jivespark/Breadboard-computer/Breadboard computer/Breadboard computer.kicad_pcb

## KiCad design tactile_capacitive/tactile_capacitive.kicad_sch


Parts:
C_sensor, C_sensor1, C_sensor2, C_sensor3: 3.5pF
C_wires, C_wires1, C_wires2, C_wires3: 20pF
J3: EnableA; PinHeader_1x02_P1.27mm_Vertical
J4: EnableB; PinHeader_1x02_P1.27mm_Vertical
J5: Conn_01x04_Pin; PinHeader_1x04_P1.27mm_Vertical
U1: ESP32-WROOM-32
U2: HX711; SOIC-16_3.9x9.9mm_P1.27mm
U4: L298N; TO127P2020X500X2100-15

Connections:
+5V: J3.2, J4.2, U1.2 (VDD), U4.4 (VS), U4.9 (VSS)
C1: U1.27 (IO16)
C2: U1.28 (IO17)
DT: U1.30 (IO18)
ESP_TO_LAPTOP: U1.35 (TXD0/IO1)
GND: C_sensor.2, C_sensor1.2, C_sensor2.2, C_sensor3.2, C_wires.2, C_wires1.2, C_wires2.2, C_wires3.2, U1.1 (GND), U1.15 (GND), U1.38 (GND), U1.39 (GND), U4.1 (SENSE_A), U4.8 (GND), U4.15 (SENSE_B)
LAPTOP_TO_ESP: U1.34 (RXD0/IO3)
LOAD_CLK: U1.31 (IO19)
M1: U4.2 (OUT1)
M2: U4.3 (OUT2)
MOTOR_IN1: J5.1, U1.36 (IO22), U4.5 (IN1)
MOTOR_IN2: J5.2, U1.37 (IO23), U4.7 (IN2)
unnamed: J3.1, U4.6 (ENA)
unnamed: J4.1, U4.11 (ENB)
unnamed: J5.3, U4.10 (IN3)
unnamed: J5.4, U4.12 (IN4)
OUT3: U4.13 (OUT3)
OUT4: U4.14 (OUT4)
TOUCH0: C_sensor.1, C_wires.1, U1.26 (IO4)
TOUCH1: U1.25 (IO0)
TOUCH2: U1.24 (IO2)
TOUCH3: U1.23 (IO15)
TOUCH4: C_sensor2.1, C_wires2.1, U1.16 (IO13)
TOUCH5: C_sensor3.1, C_wires3.1, U1.14 (IO12)
TOUCH6: C_sensor1.1, C_wires1.1, U1.13 (IO14)
TOUCH7: U1.12 (IO27)
TOUCH8: U1.9 (IO33)
TOUCH9: U1.8 (IO32)

Notes on the sheet:
Load cell
HX711 interface
N20 DC Motor
L298N Motor Driver Board
