jivespark/Breadboard-computer/JOURNAL.md

# Breadboard computer: devlog

<!-- Generated by Half Life from project ivid1p114e8rbldl7r3ygqwc. Edits here are overwritten on the next sync. -->
<!-- Generated: 2026-11-08T14:51:28.081Z -->

> [!NOTE]
> This devlog is mirrored from [Half Life](https://halflife.hackclub.com) ([open the project](https://halflife.hackclub.com/projects/ivid1p114e8rbldl7r3ygqwc)). Editing it here will not change the platform's copy, and the next sync overwrites this file.

> An 8 bit 74HC series based computer on a fully custom architecture, by me. It's using an 8 bit data bus with 4 bit memory addresses, with 5V logic.

| Week | Tier | Hours logged | Entries |
| --- | --- | --- | --- |
| Week 5 | Tier 2 | 17h | 8 |

## Contents

1. [2026-11-03: In this session I did the ALU, and registers. First I did the ALU, it wasn't too complicated, I only had to chain two 4 bit adders together, and wire all the inputs and outputs correctly.](#2026-11-03-in-this-session-i-did-the-alu-and-registers-first)
2. [2026-11-03: So in this session I did the  clock and the  program counter. First for the clock, I did the schematic mainly based on Ben Eaters design, he explains stuff really well, and for the clock my design mat](#2026-11-03-so-in-this-session-i-did-the-clock-and-the-progra)
3. [2026-11-04: Soo in this session I did the PROM. I decided to go with a harvard architecture, that just means that I have a seperate PROM(program read only memory), which stores the program, and a DRAM(data random](#2026-11-04-soo-in-this-session-i-did-the-prom-i-decided-to-g)
4. [2026-11-05: In this session, I did the DRAM. I thought it would be an easy thing, but as it turned out, it wasn't too simple, First I did a MAR(Memory Address Register), which was a bit complicated, most of the h](#2026-11-05-in-this-session-i-did-the-dram-i-thought-it-would)
5. [2026-11-05: In this session, I did the IR(Instruction Register). For it I just had to connect the DROM outputs to three 4 bit registers, and make the output control stuff. For me this is also the control unit, si](#2026-11-05-in-this-session-i-did-the-irinstruction-register-)
6. [2026-11-06: The week has finally come to an end, so I have more time to work. In this session, I first did the output register, organized some of the wiring, and I also had to redo the DRAM, and PROM. So first fo](#2026-11-06-the-week-has-finally-come-to-an-end-so-i-have-mor)
7. [2026-11-07: In this session, I first did some checking,and after that, I made most of the BOM. For the first part I just ran ERC, I had  a few errors, but most of them could be ignored, but there were some unconn](#2026-11-07-in-this-session-i-first-did-some-checkingand-afte)
8. [2026-11-08: So in this session I finished the BOM, did the README, and did some finishing touches. First I found all the components I still needed, including resistors capacitors, breadboards, etc. Finding everyt](#2026-11-08-so-in-this-session-i-finished-the-bom-did-the-rea)

## Design

### 2026-11-03: In this session I did the ALU, and registers. First I did the ALU, it wasn't too complicated, I only had to chain two 4 bit adders together, and wire all the inputs and outputs correctly.

**2h**

In this session I did the ALU, and registers. First I did the ALU, it wasn't too complicated, I only had to chain two 4 bit adders together, and wire all the inputs and outputs correctly.

Screenshot from 2026-11-02 16-13-09

Regarding the inputs and outputs, I did the registers and the BUS. For the registers I did registers for 2 numbers, the ones to add. For each one, they are done by wiring up two 4 bit registers together, and adding clock, and save signals, etc. One harder part was finding out how buses work, since KiCad does it pretty weird, but I managed to figure it out.

Screenshot from 2026-11-02 17-07-58

After the registers, I also did some buffers for the ALU, so it can be controlled when it writes to the BUS, so here is how that turned out in the end.

Screenshot from 2026-11-02 18-27-10

That's it for today, my next plan is to do the clock and the program counter tomorrow, so I might research a bit about that tonight.

### 2026-11-03: So in this session I did the  clock and the  program counter. First for the clock, I did the schematic mainly based on Ben Eaters design, he explains stuff really well, and for the clock my design mat

**2h**

So in this session I did the  clock and the  program counter. First for the clock, I did the schematic mainly based on Ben Eaters design, he explains stuff really well, and for the clock my design matched his, so I could follow his explanations. I built a clock with 2 modes, a regular timed, and also a manual button clock based design. Here is the astable(regular) timer design:



And also here is the monostable(button controlled) design:


(for the debouncing I used a 555 timer)

I then built a combined bistable design, that means that there is a switch that lets me select between the 2 modes, with it's own debouncing:



Then I had to combine the 3 outputs, to make the select signal actually select between the 2, and I also added a halt signal that stops the clock when pulled high, and here is how that turned out:



After that I built the program counter, which was a much simpler process, mainly just wiring stuff up to the bus, and a few control signals:



### 2026-11-04: Soo in this session I did the PROM. I decided to go with a harvard architecture, that just means that I have a seperate PROM(program read only memory), which stores the program, and a DRAM(data random

**2h**

Soo in this session I did the PROM. I decided to go with a harvard architecture, that just means that I have a seperate PROM(program read only memory), which stores the program, and a DRAM(data random access memory), for storing stuff like data and variables. I went with a 12 bit construction, because if I would have stayed with the regular 8 bit design, it would only have 4 opcodes, and that would need an EEPROM for controlling everything, and that would be more complicated and costly. Like this I have 4 pins for an address, and 8 opcodes, for different operations. For the RAM module I found no symbol, so I had to do a custom one, it doesn't look the best, but its usable:

Screenshot from 2026-11-04 17-08-11

After that I just had to chain 3 of these together, and connect inverters, because the outputs are inverted, and I also hooked up some dip switches, so that it could be programmed, and had to connect everything. The wiring didn't end up too beautiful, but it is functional:

Screenshot from 2026-11-04 18-48-13

I know I'm still missing the instruction register, and I'm also not sure, how I'll do the control logic, so I'll need to think it through, but overall I think I'm doing pretty good.

### 2026-11-05: In this session, I did the DRAM. I thought it would be an easy thing, but as it turned out, it wasn't too simple, First I did a MAR(Memory Address Register), which was a bit complicated, most of the h

**2h**

In this session, I did the DRAM. I thought it would be an easy thing, but as it turned out, it wasn't too simple, First I did a MAR(Memory Address Register), which was a bit complicated, most of the harder stuff was just to wire it up in a way, so that I can use a push switch, and dip switches to manually save an address into the register, but in the end I figured it out using a multiplexer and 2 AND gates.



After that I started working on the RAM modules themselves. They weren't too hard to wire, I did them similarly to my PROM, only harder part was again having to use 2 multiplexers to be able to select between reading from the bus, and using dip switches to enter values manually



(I don't really like how the wiring turned out, but if I have time later, I'll try making it cleaner)
After that, I just had to make it output onto the BUS. That wasn't too complicated, just a simple bus driver module. I made it controllable by 2 signals, one for reading from the BUS, and saving it to an address, the the other is to read from an address, and save to the BUS. This way I can control it with not too many pins. I also did a plan for the programming, but I did that in a notebook, so I can't include that here. Here is the full finished schematic:



### 2026-11-05: In this session, I did the IR(Instruction Register). For it I just had to connect the DROM outputs to three 4 bit registers, and make the output control stuff. For me this is also the control unit, si

**1.5h**

In this session, I did the IR(Instruction Register). For it I just had to connect the DROM outputs to three 4 bit registers, and make the output control stuff. For me this is also the control unit, since I have no EEPROM running some control logic, instead I built a custom mode to program this. This doesn't follow any standard, I just built it in a way that is relatively easy for me to understand, and is also functional. Since I use a 12 bit PROM, each operation is 12 bits, the first 4 being the address, the code either uses it to access a DRAM address, or have an address to jump to. The last 8 bits are for controlling what writes to, and reads from the bus, and other functionalities, like clock halt, etc. For example 000101001000 saves the sum of the values in reg A and B, and saves them to the 0001 DRAM address. I'll explain it better in the README. Here is the finished schematic:



 After this was done, I had to connect every control pin to what they control, I did that on the main sheet, here is how that turned out. I also changed some global labels to hierarchical labels to make it cleaner, and also I replaced the bus output terminals with another chip, since the one I used was 4 bit, so I needed 2, and now it's 8 bit, so I only need one, and it's also easier to control

Screenshot from 2026-11-05 21-33-52

### 2026-11-06: The week has finally come to an end, so I have more time to work. In this session, I first did the output register, organized some of the wiring, and I also had to redo the DRAM, and PROM. So first fo

**3h**

The week has finally come to an end, so I have more time to work. In this session, I first did the output register, organized some of the wiring, and I also had to redo the DRAM, and PROM. So first for the output register, I did some pretty simple stuff, just a regular register wired up to a bunch of LEDs



After that for the wiring, I redid some parts I didn't like, that was pretty straightforward, but I think it looked better, especially here around the PROM.(Sadly because of the problem I found later I had to delete this)

Screenshot from 2026-11-06 19-06-59

For last, the part that took me the most time, was redoing most of the PROM and DRAM. But why did I have to do this? It was because I used a chip for the RAM that I later realized is near impossible to source, so I had to switch to a different module. Sadly this is a lot harder to wire, so first for the DRAM, it actually made it a bit simpler, but it took quite a bit to figure out. Here is how that turned out:



After that I did the PROM, that took a lot more thinking to figure out. In the end I used a second smaller bus to handle writing and reading the 12 bit data, and here is that:



### 2026-11-07: In this session, I first did some checking,and after that, I made most of the BOM. For the first part I just ran ERC, I had  a few errors, but most of them could be ignored, but there were some unconn

**1.5h**

In this session, I first did some checking,and after that, I made most of the BOM. For the first part I just ran ERC, I had  a few errors, but most of them could be ignored, but there were some unconnected items that I needed to fix, but after it was finished.

After that I did the BOM. It was honestly pretty straightforward, I just had to find all the parts I needed on LCSC, and add them to the BOM. The hardest part to find was the RAM, they didn't have it on LCSC, so I had to find it on Aliexpress, but after I did that, it was pretty easy. I didn't yet add any passives, and breadboards, wires, etc. only the chips. Here is my original parts list I wrote together:



And here is the finished BOM, it honestly came out cheaper than what I was expecting, so I'm happy about that:



### 2026-11-08: So in this session I finished the BOM, did the README, and did some finishing touches. First I found all the components I still needed, including resistors capacitors, breadboards, etc. Finding everyt

**3h**

So in this session I finished the BOM, did the README, and did some finishing touches. First I found all the components I still needed, including resistors capacitors, breadboards, etc. Finding everything was a lot harder than with the chips, since there were lots of options for everything. In the end it ended up being over the budget, but since I have the breadboards at home, I'll make it within the budget. I didn't know if I should add that to the BOM, and cart screenshots, but I added it in the end. Here are how the totals turned out:

Screenshot from 2026-11-08 15-12-04

Screenshot from 2026-11-08 15-14-58

After that was done, I wrote the README. It was a long time to write, but in the end I managed to pull it off in a pretty understandable way I think. I also organized the files, added images, etc. Here is the finished BOM:



(Actually this is only the beginning, there is a whole other section on programming I just didn't include that here)

Now I think I'm ready to submit, so I'll do that now.
