jivespark/Breadboard-computer/(commit log)

2026-11-02 Added KiCad files, did the registers, and ALU
    [Breadboard computer.kicad_pcb, Breadboard computer.kicad_sch]
2026-11-02 Some small changes to the schematic
    [Breadboard computer.kicad_sch]
2026-11-05 Did a lot of changes, forgot to commit
    [ALU.kicad_sch, Breadboard computer.kicad_sch, CLK.kicad_sch, DRAM.kicad_sch, IR.kicad_sch, PC.kicad_sch, PROM.kicad_sch]
2026-11-06 Organized schematic, did the output register, redid RAM
    [ALU.kicad_sch, Breadboard computer.kicad_sch, CLK.kicad_sch, DRAM.kicad_sch, IR.kicad_sch, OUT.kicad_sch, PC.kicad_sch, PROM.kicad_sch]
2026-11-08 Fixed some things
    [ALU.kicad_sch, CLK.kicad_sch, DRAM.kicad_sch, IR.kicad_sch, OUT.kicad_sch, PC.kicad_sch, PROM.kicad_sch]
2026-11-08 Sync Breadboard computer from Half Life
    [BOM.csv]
2026-11-08 Updated README with pictures, and BOM
